GreatMedivack/wordclock/led-clock/concepts/wall_concept_ru.png

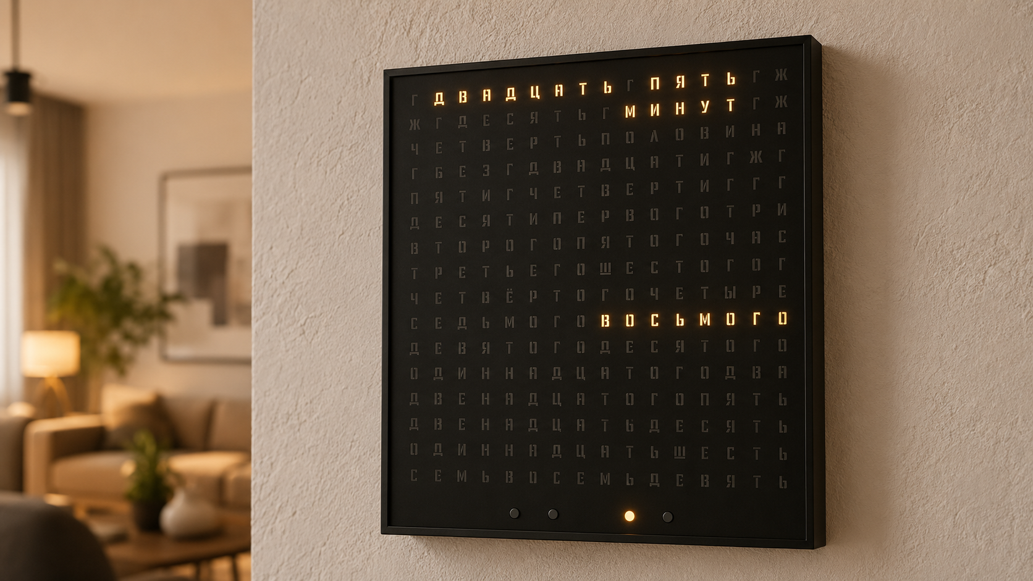
led-clock/concepts/wall_concept_ru.png
