GreatMedivack/wordclock/README.md

# Словесные часы / Word Clock RU

Настенные часы, которые показывают время словами на русском языке. 260 светодиодов WS2812B (сетка 16×16 + 4 точки для дополнительных минут), управляемых ESP32-S3 через WiFi/NTP.

12-часовая демонстрация

## Как читать время

Часы подсвечивают русские слова, складывающиеся в естественную фразу:

| Время | Фраза |
|---|---|
| 1:00 | ЧАС |
| 2:15 | ЧЕТВЕРТЬ ТРЕТЬЕГО |
| 5:30 | ПОЛОВИНА ШЕСТОГО |
| 7:45 | БЕЗ ЧЕТВЕРТИ ВОСЕМЬ |
| 11:55 | БЕЗ ПЯТИ ДВЕНАДЦАТЬ |

4 точки под сеткой показывают остаток минут (±2) сверх ближайшей пятиминутки.

## Структура

```
led-clock/                 — LED-часы (основной проект)
  arduino/wordclock_ru/    — прошивка ESP32 (Arduino), SVG шаблоны, BOM, схема
  micropython/             — альтернативная прошивка MicroPython
  tools/                   — генераторы сеток, рендеры, GIF-демо, тесты
  concepts/                — концепт-рендеры
  pitch/                   — презентация проекта

epaper/                    — e-paper тестовый стенд (Pi Zero W)
  clock_ru.py              — главный цикл
  renderer_ru.py           — рендерер для e-paper дисплея
  epd_driver.py            — драйвер Waveshare 2.13" e-Paper V4
  time_source.py           — источник времени (RTC / system fallback)
  deploy/                  — скрипты развёртывания на Raspberry Pi
```

## LED-часы (основной)

Подробности: [led-clock/](led-clock/)

- **MCU**: ESP32-S3 DevKitC (WiFi, NTP)
- **LED**: 260× WS2812B (сетка 16×16 + 4 точки)
- **Шрифт**: USSR Stencil (трафаретный, с перемычками)
- **Питание**: 5V 5A
- **Бюджет**: ~3 300₽ за макет

## E-paper тестовый стенд

Raspberry Pi Zero W + Waveshare 2.13" e-Paper HAT V4. Используется для отладки логики отображения времени без LED-железа.

```bash
# Деплой на Pi
./epaper/deploy/prepare-sd.sh /media/$USER
# Или через SSH
./epaper/install.sh
```
