GreatMedivack/wordclock/led-clock/README.md

# LED Word Clock RU

Настенные словесные часы с сеткой 16×16 русских букв и 4 точками для дополнительных минут. 260 индивидуально адресуемых WS2812B LED, управляемых ESP32-S3.

## Сетка букв

```
Г  Д  В  А  Д  Ц  А  Т  Ь  Г  П  Я  Т  Ь  Г  Ж
Ж  Г  Д  Е  С  Я  Т  Ь  Г  М  И  Н  У  Т  Г  Ж
Ч  Е  Т  В  Е  Р  Т  Ь  П  О  Л  О  В  И  Н  А
Г  Б  Е  З  Г  Д  В  А  Д  Ц  А  Т  И  Г  Ж  Г
П  Я  Т  И  Г  Ч  Е  Т  В  Е  Р  Т  И  Г  Г  Г
Д  Е  С  Я  Т  И  П  Е  Р  В  О  Г  О  Т  Р  И
В  Т  О  Р  О  Г  О  П  Я  Т  О  Г  О  Ч  А  С
Т  Р  Е  Т  Ь  Е  Г  О  Ш  Е  С  Т  О  Г  О  Г
Ч  Е  Т  В  Ё  Р  Т  О  Г  О  Ч  Е  Т  Ы  Р  Е
С  Е  Д  Ь  М  О  Г  О  В  О  С  Ь  М  О  Г  О
Д  Е  В  Я  Т  О  Г  О  Д  Е  С  Я  Т  О  Г  О
О  Д  И  Н  Н  А  Д  Ц  А  Т  О  Г  О  Д  В  А
Д  В  Е  Н  А  Д  Ц  А  Т  О  Г  О  П  Я  Т  Ь
Д  В  Е  Н  А  Д  Ц  А  Т  Ь  Д  Е  С  Я  Т  Ь
О  Д  И  Н  Н  А  Д  Ц  А  Т  Ь  Ш  Е  С  Т  Ь
С  Е  М  Ь  В  О  С  Е  М  Ь  Д  Е  В  Я  Т  Ь
                    ●  ●     ●  ●
```

Строки 0–4: модификаторы времени (ДВАДЦАТЬ, ПЯТЬ, ДЕСЯТЬ, МИНУТ, ЧЕТВЕРТЬ, ПОЛОВИНА, БЕЗ...).
Строки 5–12: часы в родительном падеже (ПЕРВОГО...ДВЕНАДЦАТОГО).
Строки 12–15: часы в именительном падеже (ЧАС, ДВА...ДВЕНАДЦАТЬ).
4 точки внизу: ±2 минуты к ближайшей пятиминутке.

## Железо

Детали в [arduino/wordclock_ru/BOM.md](arduino/wordclock_ru/BOM.md) и [arduino/wordclock_ru/WIRING.md](arduino/wordclock_ru/WIRING.md).

| Компонент | Описание |
|---|---|
| ESP32-S3 DevKitC | WiFi, NTP, 1× GPIO для данных |
| WS2812B × 260 | 16 полос по 16 LED + 4 точки |
| Блок питания 5V 5A | Для ленты, ESP32 от USB |
| Резистор 330Ω | На линии данных |
| Конденсатор 1000µF | На входе питания ленты |

## Прошивка

### Arduino (основной вариант)

```bash
# arduino/wordclock_ru/wordclock_ru.ino
# Задать WIFI_SSID, WIFI_PASSWORD, GMT_OFFSET
# Библиотека: FastLED
```

### MicroPython (альтернатива)

```bash
# Скопировать micropython/boot.py и micropython/main.py на ESP32
# Задать WiFi и UTC_OFFSET в main.py
```

## Сборка

```
┌─────────────────────────────────────┐
│  1. Задняя панель (фанера/акрил)    │  ← LED-лента приклеена змейкой
│  2. WS2812B лента (260 LED)         │
│  3. Перегородки (баффл)             │  ← предотвращают засветку соседних букв
│  4. Рассеиватель (матовый акрил)    │  ← смягчает точечный свет LED
│  5. Трафарет с буквами             │  ← USSR Stencil шрифт
│  6. Рамка                           │
└─────────────────────────────────────┘
```

## Инструменты

| Скрипт | Назначение |
|---|---|
| `tools/gen_gif_demo.py` | GIF-демо всех 720 минут за 12 часов |
| `tools/gen_svg_panels.py` | SVG шаблоны для лазерной резки |
| `tools/gen_stencil_v3.py` | SVG трафарет букв |
| `tools/grid16x16_render.py` | Рендер сетки с подсветкой слов |
| `tools/build_grid_ru_v2.py` | Генератор/валидатор сетки |
| `tools/test_grid.py` | Тесты корректности для всех 720 минут |

## SVG шаблоны

В `arduino/wordclock_ru/`:

- `panel_front.svg` — лицевая панель с буквами
- `panel_stencil.svg` — трафарет для резки
- `cutting_template.svg` — шаблон для раскроя перегородок
- `baffle_grid.svg` — сетка перегородок
