GreatMedivack/wordclock/led-clock/concepts/grid_reference_ru.png

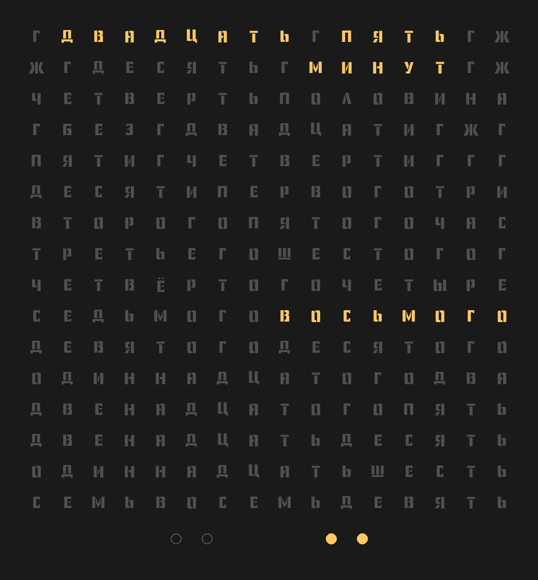
led-clock/concepts/grid_reference_ru.png
