GreatMedivack/wordclock/preview_ru.png

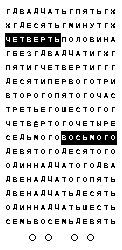
preview_ru.png
