GreatMedivack/wordclock/led-clock/arduino/wordclock_ru/BOM.md

# Word Clock RU v2 — Смета макета для отладки

Паяльник и припой уже есть.

## Компоненты

| # | Компонент | Цена | Ссылка |
|---|---|---|---|
| 1 | WS2812B лента 60 LED/m, 5м, IP30, чёрная PCB, DC5V | ~1 200₽ | [AliExpress](https://www.aliexpress.com/item/2036819167.html) |
| 2 | ESP32-S3-DevKitC-1 (N8R2, 8MB Flash + 2MB PSRAM) | ~800₽ | [AliExpress](https://www.aliexpress.com/item/1005003984006664.html) |
| 3 | Блок питания 5V 5A 25W, адаптер для LED | ~650₽ | [AliExpress](https://www.aliexpress.com/item/33050368364.html) |
| 4 | Провода силикон 22AWG, 5 цветов, 30м | ~250₽ | [AliExpress](https://ru.aliexpress.com/item/32829720045.html) |
| 5 | Набор резисторов (600 шт, включая 330Ω) | ~100₽ | [AliExpress](https://www.aliexpress.com/w/wholesale-resistor-kit.html) |
| 6 | Конденсатор электролит. 1000µF 6.3-10V (10 шт) | ~50₽ | [AliExpress](https://www.aliexpress.com/w/wholesale-capacitor-resistor-kit.html) |

| | **Итого электроника** | **~3 050₽** | |

## Расходники (локально)

| # | Что | Цена | Где |
|---|-----|---|-----|
| 7 | Гофрокартон 30×30 см | 0₽ | Любая коробка |
| 8 | Пергамент для выпечки (рассеиватель) | ~100₽ | Супермаркет |
| 9 | Двусторонний скотч / термоклей | ~100₽ | Фикспрайс |
| 10 | Печать букв на А3 | ~50₽ | Копицентр |

| | **Итого расходники** | **~250₽** | |

## Итого: ~3 300₽

## Примечания

- Лента 5м — с запасом, нужно 4.33м (16 полос × 16 LED + 4 LED точки)
- Провода 30м — хватит на все перемычки между полосами и инжекцию питания
- ESP32 питается от USB компа (Serial Monitor для отладки), лента от отдельного 5V БП
- GND ESP32 и GND ленты обязательно соединить
- При BRIGHTNESS=20-40 одного входа 5V 5A хватит без инжекции
- Резисторы и конденсаторы продаются наборами — останется про запас
