GreatMedivack/wordclock/led-clock/arduino/wordclock_ru/WIRING.md

# Word Clock RU v2 — Схема пайки и подключения

## Компоненты

| Компонент | Кол-во | Описание |
|---|---|---|
| WS2812B LED | 260 шт | 256 сетка + 4 точки (доп. минуты) |
| ESP32-S3 DevKitC | 1 | Контроллер, WiFi + NTP |
| Конденсатор 1000µF 6.3V | 1 | На вход питания LED-ленты |
| Резистор 330Ω | 1 | Между GPIO48 и DATA IN первого LED |
| Блок питания 5V 5A | 1 | ~15W для 260 LED при 40 яркости |
| Провода | — | 22AWG для питания, 26AWG для данных |

## Сетка 16×16 — Serpentine (змейка)

LED нумеруются слева направо на чётных строках, справа налево на нечётных.
Это стандартная раскладка для LED-лент, уложенных зигзагом.

```
Вид СЗАДИ (сторона пайки, зеркально к лицевой):

  DATA IN (GPIO48) ──► здесь
  ┌──────────────────────────────────────────────────┐
  │                                                  │
  │  Row 0  (L→R):  LED   0 →   1 →   2 → ... →  15 │──┐
  │  Row 1  (R→L):  LED  31 ←  30 ←  29 ← ... ←  16 │←─┘
  │  Row 2  (L→R):  LED  32 →  33 →  34 → ... →  47 │──┐
  │  Row 3  (R→L):  LED  63 ←  62 ←  61 ← ... ←  48 │←─┘
  │  ...                                              │
  │  Row 14 (L→R):  LED 224 → 225 → 226 → ... → 239 │──┐
  │  Row 15 (R→L):  LED 255 ← 254 ← 253 ← ... ← 240 │←─┘
  │                                                  │
  └──────────────────────────────────────────────────┘
```

### Формула LED-индекса

```
ledIndex(row, col):
    if row % 2 == 0:  return row * 16 + col        // L→R
    else:             return row * 16 + (15 - col)  // R→L
```

## Раскладка букв (вид СПЕРЕДИ, как читает человек)

```
Col:  0  1  2  3  4  5  6  7  8  9 10 11 12 13 14 15

 0:   К  Г  Д  В  А  Д  Ц  А  Т  Ь  П  Я  Т  Ь  Б  Ж
 1:   Б  В  К  Д  Е  С  Я  Т  Ь  М  И  Н  У  Т  Г  Ж
 2:   Ч  Е  Т  В  Е  Р  Т  Ь  П  О  Л  О  В  И  Н  А
 3:   К  Г  Б  Е  З  П  Я  Т  И  Д  Е  С  Я  Т  И  Д
 4:   Д  В  А  Д  Ц  А  Т  И  Ч  Е  Т  В  Е  Р  Т  И
 5:   К  П  Е  Р  В  О  Г  О  В  Т  О  Р  О  Г  О  Г
 6:   Т  Р  Е  Т  Ь  Е  Г  О  Д  Е  С  Я  Т  О  Г  О
 7:   Ч  Е  Т  В  Ё  Р  Т  О  Г  О  П  Я  Т  О  Г  О
 8:   Ш  Е  С  Т  О  Г  О  С  Е  Д  Ь  М  О  Г  О  К
 9:   В  О  С  Ь  М  О  Г  О  Д  Е  В  Я  Т  О  Г  О
10:   К  Г  О  Д  И  Н  Н  А  Д  Ц  А  Т  О  Г  О  Д
11:   К  Г  Д  В  Е  Н  А  Д  Ц  А  Т  О  Г  О  Б  Д
12:   Ч  А  С  Д  В  А  Т  Р  И  Ч  Е  Т  Ы  Р  Е  К
13:   Ш  Е  С  Т  Ь  С  Е  М  Ь  В  О  С  Е  М  Ь  К
14:   Д  Е  В  Я  Т  Ь  Д  В  Е  Н  А  Д  Ц  А  Т  Ь
15:   К  Г  Б  О  Д  И  Н  Н  А  Д  Ц  А  Т  Ь  Д  П
```

## Нумерация LED (вид СЗАДИ, сторона пайки)

Зеркально по горизонтали относительно лицевой стороны!

```
Col:  15 14 13 12 11 10  9  8  7  6  5  4  3  2  1  0

 0:    0   1   2   3   4   5   6   7   8   9  10  11  12  13  14  15
 1:   31  30  29  28  27  26  25  24  23  22  21  20  19  18  17  16
 2:   32  33  34  35  36  37  38  39  40  41  42  43  44  45  46  47
 3:   63  62  61  60  59  58  57  56  55  54  53  52  51  50  49  48
 4:   64  65  66  67  68  69  70  71  72  73  74  75  76  77  78  79
 5:   95  94  93  92  91  90  89  88  87  86  85  84  83  82  81  80
 6:   96  97  98  99 100 101 102 103 104 105 106 107 108 109 110 111
 7:  127 126 125 124 123 122 121 120 119 118 117 116 115 114 113 112
 8:  128 129 130 131 132 133 134 135 136 137 138 139 140 141 142 143
 9:  159 158 157 156 155 154 153 152 151 150 149 148 147 146 145 144
10:  160 161 162 163 164 165 166 167 168 169 170 171 172 173 174 175
11:  191 190 189 188 187 186 185 184 183 182 181 180 179 178 177 176
12:  192 193 194 195 196 197 198 199 200 201 202 203 204 205 206 207
13:  223 222 221 220 219 218 217 216 215 214 213 212 211 210 209 208
14:  224 225 226 227 228 229 230 231 232 233 234 235 236 237 238 239
15:  255 254 253 252 251 250 249 248 247 246 245 244 243 242 241 240
```

## Схема подключения

```
                         ┌─────────────────┐
                         │   ESP32-S3      │
                         │   DevKitC       │
                         │                 │
  5V PSU ─── +5V ────────┤ 5V          GND ├──── GND PSU
                         │                 │
                    330Ω │ GPIO48          │
                      ├──┤                 │
                      │  └─────────────────┘
                      │
              ┌───────┴──────────────────────────────────┐
              │  WS2812B LED Strip (256 LEDs)             │
              │                                          │
  5V PSU ─────┤ +5V                                      │
  GND PSU ────┤ GND                                      │
  DATA ───────┤ DIN                                      │
              │                                          │
              │  LED 0 → 15 → 31 ← 16 → 32 → ... → 255 │
              └──────────────────────────────────────────┘
              │
              ╪ 1000µF 6.3V (между +5V и GND, у начала ленты)
              │
```

## Инжекция питания

При 256 LED на полной яркости белого — до 15A. При BRIGHTNESS=40 (~16%) хватает 5A.
Рекомендуется инжекция питания каждые 4 ряда:

```
5V/GND ──┬── LED 0   (начало, row 0)
         ├── LED 64  (начало row 4)
         ├── LED 128 (начало row 8)
         └── LED 192 (начало row 12)
```

Паять +5V и GND напрямую к контактным площадкам ленты в этих точках.

## Резка ленты

Лента WS2812B (60 LED/m) режется на полосы по 16 LED + 1 полоса из 4 LED:

```
1 полоса = 16 LED = 26.7 см (при шаге 16.7мм)
16 полос = 256 LED = 4.27 м (буквенная сетка)
1 полоса = 4 LED  = 6.7 см  (точки доп. минут)
Итого: 260 LED = 4.33 м ленты

Раскладка (вид сзади):
    ┌────────────────────────┐
    │ → → → → → → → → → → →│──┐  Row 0 (LED 0-15)
    │ ← ← ← ← ← ← ← ← ← ←│←─┘  Row 1 (LED 16-31)
    │ → → → → → → → → → → →│──┐  Row 2 (LED 32-47)
    │ ← ← ← ← ← ← ← ← ← ←│←─┘  Row 3 (LED 48-63)
    │         ...             │
    │ → → → → → → → → → → →│──┐  Row 14 (LED 224-239)
    │ ← ← ← ← ← ← ← ← ← ←│←─┘  Row 15 (LED 240-255)
    └────────────────────────┘
              │ DATA
        ┌─────┴─────┐
        │ ● ● ● ●   │  Dots (LED 256-259)
        └────────────┘
        по центру, шаг ~67мм (4 ячейки)

    Соединение между полосами: 3 провода (5V, GND, DATA)
    Длина перемычки: ~5мм (только развернуть направление)
    Перемычка к точкам: от DOUT LED 255 → DIN LED 256
```

## Точки (доп. минуты)

4 LED (256-259) расположены по центру под буквенной сеткой.
Показывают остаток минут сверх 5-минутного округления:
- 0 точек: ровная пятиминутка
- 1 точка: +1 минута
- 2 точки: +2 минуты
- 3 точки: +3 минуты
- 4 точки: +4 минуты

Расстояние между точками: ~67мм (4 шага сетки).
Отступ от низа сетки: ~20мм.

## Порядок сборки

1. Нарезать ленту: 16 полос по 16 LED + 1 полоса из 4 LED
2. Приклеить на основу (фанера/акрил 27×29 см) зигзагом
3. Припаять перемычки DATA между полосами (3 провода: 5V, DIN→DOUT, GND)
4. Припаять инжекцию питания на rows 0, 4, 8, 12
5. Приклеить полосу из 4 LED по центру под сеткой
6. Припаять перемычку от DOUT LED 255 к DIN LED 256
7. Припаять 330Ω резистор на DATA IN первой полосы
8. Припаять конденсатор 1000µF между +5V/GND у начала
9. Подключить ESP32-S3: GPIO48 → резистор → DATA, 5V, GND
10. Залить прошивку, проверить startupSweep
11. Наложить трафарет с буквами + 4 круглых отверстия для точек
