GreatMedivack/wordclock/(commit log)

2026-05-03 Kisai-style word clock for Raspberry Pi Zero W + Waveshare 2.13" e-Paper
    Complete application and deployment setup:
    - renderer.py: 11x15 character grid, highlights hours/minutes/AM-PM
    - epd_driver.py: partial refresh every minute, full refresh every 30 cycles
    - time_source.py: PCF8523 RTC with system time fallback
    - clock.py: main loop with graceful shutdown
    - deploy/: SD card bootstrap scripts (prepare-sd, firstboot, install-deps)
    - wordclock.service: systemd autostart
    - Silkscreen pixel font for 1-bit e-paper rendering
2026-05-04 Fix e-paper flickering: eliminate redundant full refreshes and poll every 5s
    - Remove double TurnOnDisplay during ghosting cleanup (display + displayPartBaseImage → just displayPartBaseImage)
    - Remove separate show_base call that caused a third full flash on the next minute
    - Poll every 5s instead of sleeping until next minute, only refresh display on actual time change
    - Cache RTC init failure to stop retrying I2C every cycle
    [epd_driver.py, time_source.py]
2026-05-27 Add Russian natural-speech word clock for e-paper
    16×16 Cyrillic grid with natural Russian time expressions:
    ЧЕТВЕРТЬ ВОСЬМОГО (7:15), БЕЗ ДЕСЯТИ ТРИ (2:50),
    ПОЛОВИНА ДВЕНАДЦАТОГО (11:30). 4 dot indicators below
    grid for exact minutes (+1..+4 beyond 5-min rounding).
2026-05-27 Switch e-paper to portrait orientation (122×250)
    Taller cells (7×14px vs 15×7px) make Cyrillic letters
    more readable on the 2.13" Waveshare display.
2026-05-27 Round to nearest 5 minutes with ±2 dot indicators
    Instead of always rounding down (+1..+4 dots), round to the
    nearest 5-minute mark: remainder 0-2 shows + dots (right pair),
    remainder 3-4 rounds up and shows - dots (left pair). Matches
    natural Russian time perception: 1:28 → ПОЛОВИНА -2, not
    ДВАДЦАТЬ ПЯТЬ +3.
2026-05-27 Grid v4: switch e-paper to unified grid with separate NOM_5/NOM_10
    Same 16×16 grid as LED clock — zero reading order issues across all
    720 time variants. NOM_5=ПЯТЬ and NOM_10=ДЕСЯТЬ no longer share
    positions with minute modifier words.
    [renderer_ru.py]
2026-05-27 Add LED wall clock variant with EN/RU/JA language support
    ESP32-S3 + WS2812B word clock with three language grids:
    - English: 11×15 (165 LEDs) — original layout
    - Russian: 13×15 (195 LEDs) — Cyrillic grid
    - Japanese: 8×10 (80 LEDs) — kanji grid
    Includes Arduino and MicroPython firmware, grid validation tools,
    SVG templates for laser cutting and vinyl plotting, concept renders
    for all variants, and a product pitch presentation with market
    analysis and financial projections.
2026-05-27 Add supplier pricing and BOM breakdown to pitch deck
    Detailed slide with laser cutting services in SPb (Virazh, ELAM,
    ZPOS, BigCut), acrylic material suppliers (Chempion24, UnikumPlast),
    electronics pricing (ESP32-S3, WS2812B from Giant4, SMDX), and
    per-unit BOM at batch quantities of 10+.
2026-05-27 Use absolute GitHub URLs for concept images in pitch deck
2026-05-27 Convert pitch deck to horizontal slide navigation with keyboard and swipe
2026-05-27 Fix all presentation slides to fit in viewport
    - Reduce all font sizes: h2 42→26px, h3 22→15px, td 15→12px
    - Compact tables: padding 14px→4px, margins reduced throughout
    - Shrink render images: max-height 28vh→22vh, grid font 10→9px
    - Compact cards: BOM, financial, market bar all tightened
    - Split suppliers slide into two: materials + electronics BOM
    - Fix pricing slide inline sizes: 48→32px
    - Reduce notes, pills, badges, hero text sizes
    - Now 11 slides total, all fitting in single viewport
2026-05-27 Add lightbox: click renders to view fullscreen, click/Esc to close
2026-05-27 Add Russian word clock: 16×16 LED grid, 13×15 e-paper, stencil assets
    LED wall clock (16×16, 256 LEDs):
    - Natural speech format rounded to 5 min (ЧЕТВЕРТЬ ВОСЬМОГО)
    - Centered grid with USSR STENCIL font for panel cutout
    - BOM, wiring diagram, SVG templates for assembly
    E-paper clock (13×15, Raspberry Pi Zero W):
    - Exact time via digit words (ПЯТЬ НЧ ЧЕТЫРЕ СЕМЬ)
    - Liberation Mono Bold for Cyrillic rendering at 7pt
    - Shared epd_driver and time_source with English version
    Tools: grid builder/validator, stencil SVG generator
2026-05-27 Add exact minute support: 260 LEDs (16×16 grid + 4 dot indicators)
    Words show time rounded to 5 minutes, 4 dot LEDs below grid
    show +1/+2/+3/+4 extra minutes for exact time display.
    Updated wiring, BOM, grid builder and render tools.
2026-05-27 Update all SVG panels: extend height for 4 dot indicators below grid
    Panel dimensions changed from 276.72×276.72mm to 276.72×299.72mm.
    Added 4 dot circles (LED 256-259) centered 20mm below the letter grid
    with 66.68mm spacing. Added gen_svg_panels.py generator for the three
    plain-XML SVGs (panel_front, baffle_grid, cutting_template).
2026-05-27 Switch to ±2 nearest-5 rounding for dot indicators
    Round to nearest 5-minute mark instead of always rounding down.
    Left dot pair shows minus minutes, right pair shows plus minutes,
    filled from center outward. Handles hour rollover at m5=60.
2026-05-27 Grid v4: eliminate all reading order issues with separate NOM_5/NOM_10
    Separate NOM_5=ПЯТЬ (row 12) and NOM_10=ДЕСЯТЬ (row 13) from minute
    words on rows 0-1, fixing all 10 reading order issues where БЕЗ...ПЯТЬ
    and БЕЗ...ДЕСЯТЬ read out of order. Redistribute NOM hours across GEN
    rows (never co-active): ТРИ→5, ЧАС→6, ЧЕТЫРЕ→8, ДВА→11. Move ДЕСЯТИ
    to row 5, ЧЕТВЕРТИ to row 4. Zero collisions, zero reading order issues
    across all 720 time variants. 237 active chars, 19 fillers.
    Update all files: firmware, Pi renderer (rewritten to natural speech
    format), test suite, SVG/stencil generators, GIF/PNG renderers.
    [clock_ru.py, renderer_ru.py]
2026-05-27 Add 12h demo GIF, grid render variants, and updated SVG panels
    - Regenerate gen_gif_demo.py with USSR STENCIL font, time labels, 2s/frame
    - Add 16x16, 17x16, 20x16 grid render scripts and preview images
    - Update SVG panels, baffle grid, and cutting template for v4 grid
    - Update presentation and concept images
2026-05-27 Consolidate project: Russian LED wall clock + e-paper test bench
    Remove English/Japanese variants, unused grid sizes (17x16, 20x16),
    old previews, and unused fonts. Keep only Russian 16x16 LED wall clock
    as the main project and Pi Zero e-paper as a debugging test bench.
    Rewrite README for the focused project scope.
2026-05-27 Maximize font size to fill grid cells in all renders and SVGs
    USSR Stencil: CELL=40→FONT_SIZE=44, CELL=52→FONT_SIZE=57,
    PITCH=16.67mm→FONT_SIZE=17.6mm. Also switch grid16x16_render.py
    from LiberationMono to USSR Stencil for consistency.
2026-05-27 Move dots under columns 5,6 and 9,10 (below ОС and ЬД)
